damianmoore/audio-lighting-broadcast/kicad/transmitter/transmitter.kicad_pcb

## KiCad design kicad/transmitter/transmitter.kicad_pcb (2020-02-24)

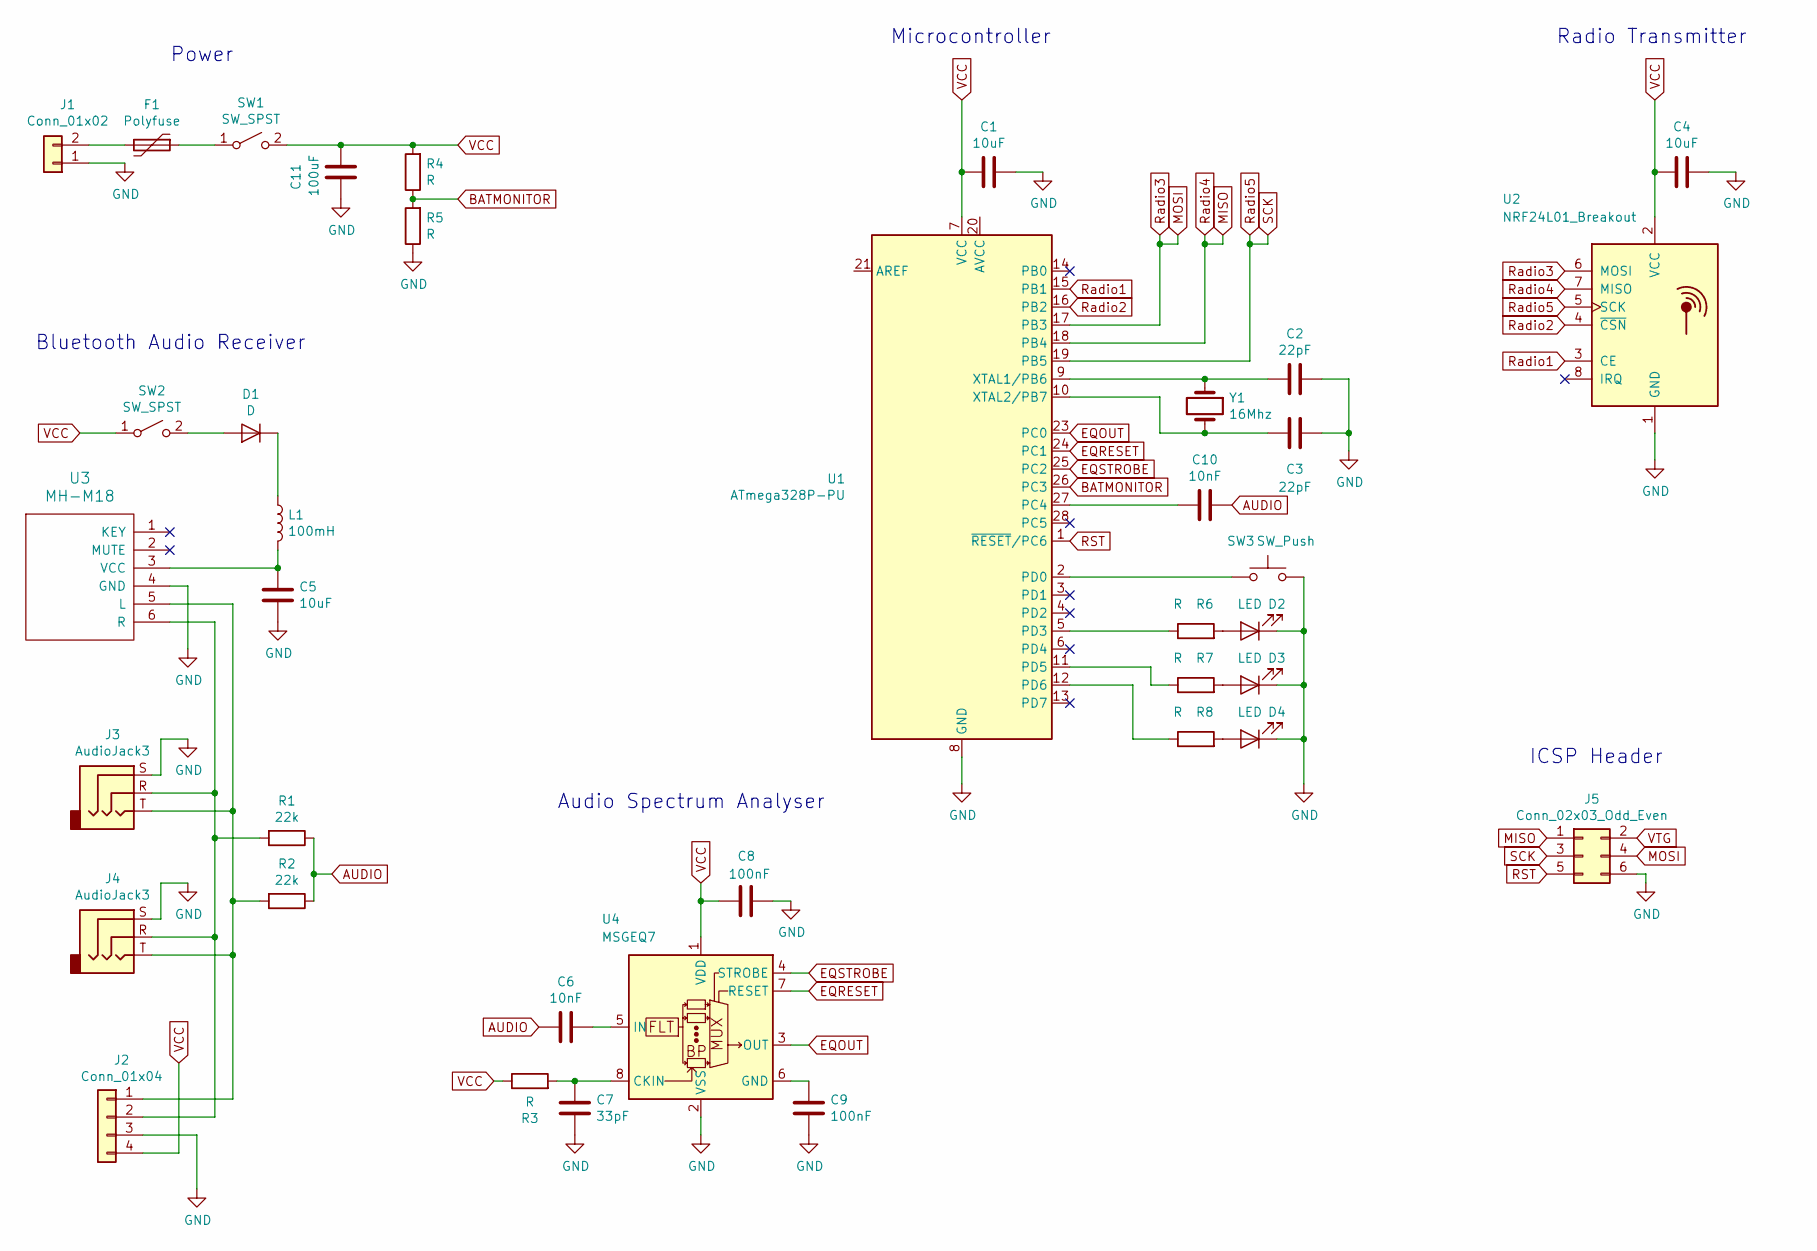
[picture p1: schematic transmitter.sch]

Parts:
C1, C4, C5: 10uF; C_0603_1608Metric_Pad1.05x0.95mm_HandSolder
C2, C3: 22pF; C_0603_1608Metric_Pad1.05x0.95mm_HandSolder
C6, C10: 10nF; C_0603_1608Metric_Pad1.05x0.95mm_HandSolder
C7: 33pF; C_0603_1608Metric_Pad1.05x0.95mm_HandSolder
C8, C9: 100nF; C_0603_1608Metric_Pad1.05x0.95mm_HandSolder
C11: 100uF; CP_Radial_D6.3mm_P2.50mm
D1: D; D_A-405_P7.62mm_Horizontal
D2, D3, D4: LED; LED_D3.0mm
F1: Polyfuse; Resonator-2Pin_W6.0mm_H3.0mm
J1: Conn_01x02; SolderWirePad_1x02_P3.81mm_Drill1mm
J2: Conn_01x04; PinHeader_1x04_P2.54mm_Vertical
J3, J4: AudioJack3; 3.5mm_Stereo_Jack
J5: Conn_02x03_Odd_Even; PinHeader_2x03_P2.54mm_Vertical
L1: 100mH; L_Toroid_Vertical_L16.0mm_W8.0mm_P7.62mm
R1, R2: 22k; R_0603_1608Metric_Pad1.05x0.95mm_HandSolder
R3, R4, R5, R6, R7, R8: R; R_0603_1608Metric_Pad1.05x0.95mm_HandSolder
SW1, SW2: SW_SPST; PinHeader_1x02_P2.54mm_Vertical
SW3: SW_Push; PinHeader_1x02_P2.54mm_Vertical
U1: ATmega328P-PU; DIP-28_W7.62mm
U2: NRF24L01_Breakout; nRF24L01_Breakout
U3: MH-M18; MH-M18_Bluetooth_Audio
U4: MSGEQ7; DIP-8_W10.16mm
Y1: 16Mhz; Crystal_HC18-U_Vertical

Connections:
AUDIO: C6.2, C10.1, R1.1, R2.1
BATMONITOR: R4.1, R5.2, U1.26 (PC3)
EQOUT: U1.23 (PC0), U4.3 (OUT)
EQRESET: U1.24 (PC1), U4.7 (RESET)
EQSTROBE: U1.25 (PC2), U4.4 (STROBE)
GND: C1.1, C2.1, C3.1, C4.1, C5.2, C7.1, C8.2, C9.1, C11.1, D2.1 (K), D3.1 (K), D4.1 (K), J1.1, J2.3, J3.S, J4.S, J5.6, R5.1, SW3.2, U1.8 (GND), U1.22 (GND), U2.1 (GND), U3.4 (GND), U4.2 (VSS)
MISO: J5.1, U1.18 (PB4), U2.7 (MISO)
MOSI: J5.4, U1.17 (PB3), U2.6 (MOSI)
unnamed: C2.2, U1.9 (XTAL1/PB6), Y1.1
unnamed: C3.2, U1.10 (XTAL2/PB7), Y1.2
unnamed: C5.1, L1.2, U3.3 (VCC)
unnamed: C6.1, U4.5 (IN)
unnamed: C7.2, R3.2, U4.8 (CKIN)
unnamed: C9.2, U4.6 (GND)
unnamed: C10.2, U1.27 (PC4)
unnamed: D1.1 (K), L1.1
unnamed: D1.2 (A), SW2.2 (B)
unnamed: D2.2 (A), R6.2
unnamed: D3.2 (A), R7.2
unnamed: D4.2 (A), R8.2
unnamed: F1.1, SW1.1 (A)
unnamed: F1.2, J1.2
unnamed: J2.1, J3.T, J4.T, R2.2, U3.5 (L)
unnamed: J2.2, J3.R, J4.R, R1.2, U3.6 (R)
unnamed: R6.1, U1.5 (PD3)
unnamed: R7.1, U1.11 (PD5)
unnamed: R8.1, U1.12 (PD6)
unnamed: SW3.1, U1.2 (PD0)
RST: J5.5, U1.1 (~RESET~/PC6)
Radio1: U1.15 (PB1), U2.3 (CE)
Radio2: U1.16 (PB2), U2.4 (~CSN)
Radio5: J5.3, U1.19 (PB5), U2.5 (SCK)
VCC: C1.2, C4.2, C8.1, C11.2, J2.4, R3.1, R4.2, SW1.2 (B), SW2.1 (A), U1.7 (VCC), U2.2 (VCC), U4.1 (VDD)
VTG: J5.2

Notes on the sheet:
Power
Bluetooth Audio Receiver
Audio Spectrum Analyser
Microcontroller
Radio Transmitter
ICSP Header

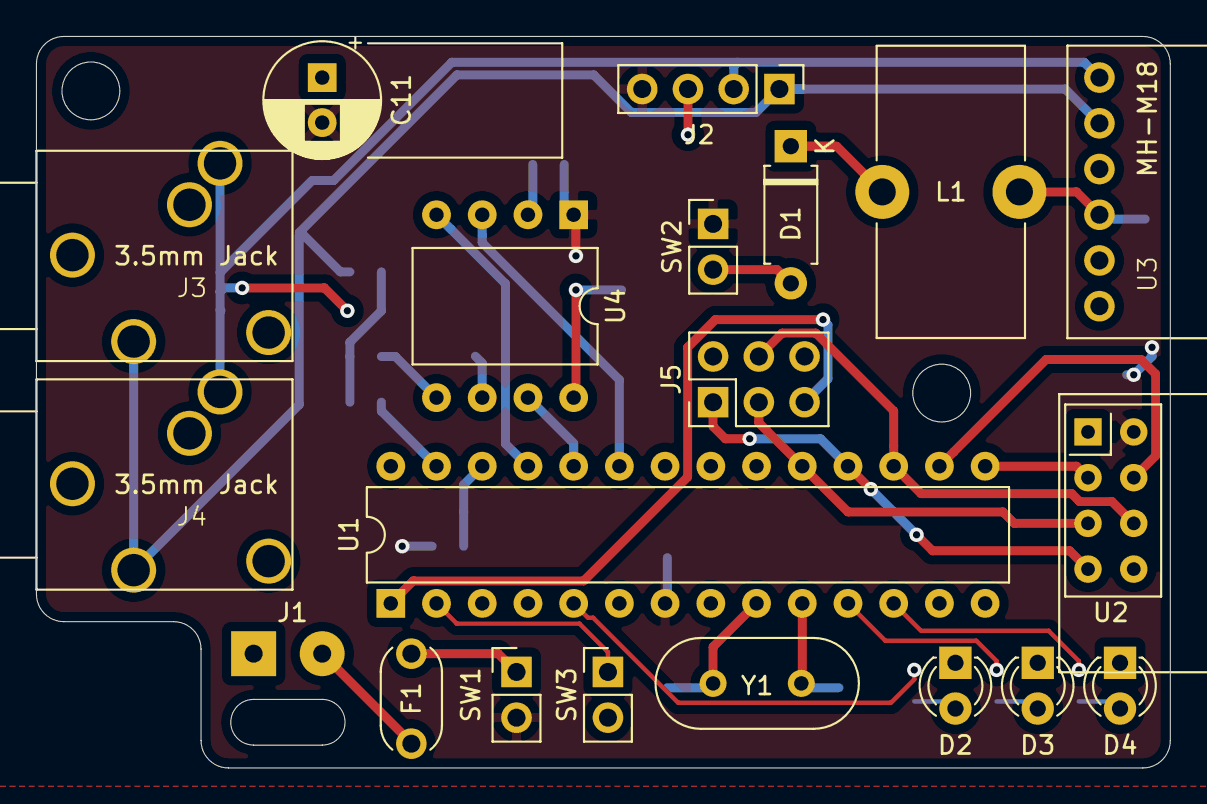
[picture p2: board transmitter.kicad_pcb from above]

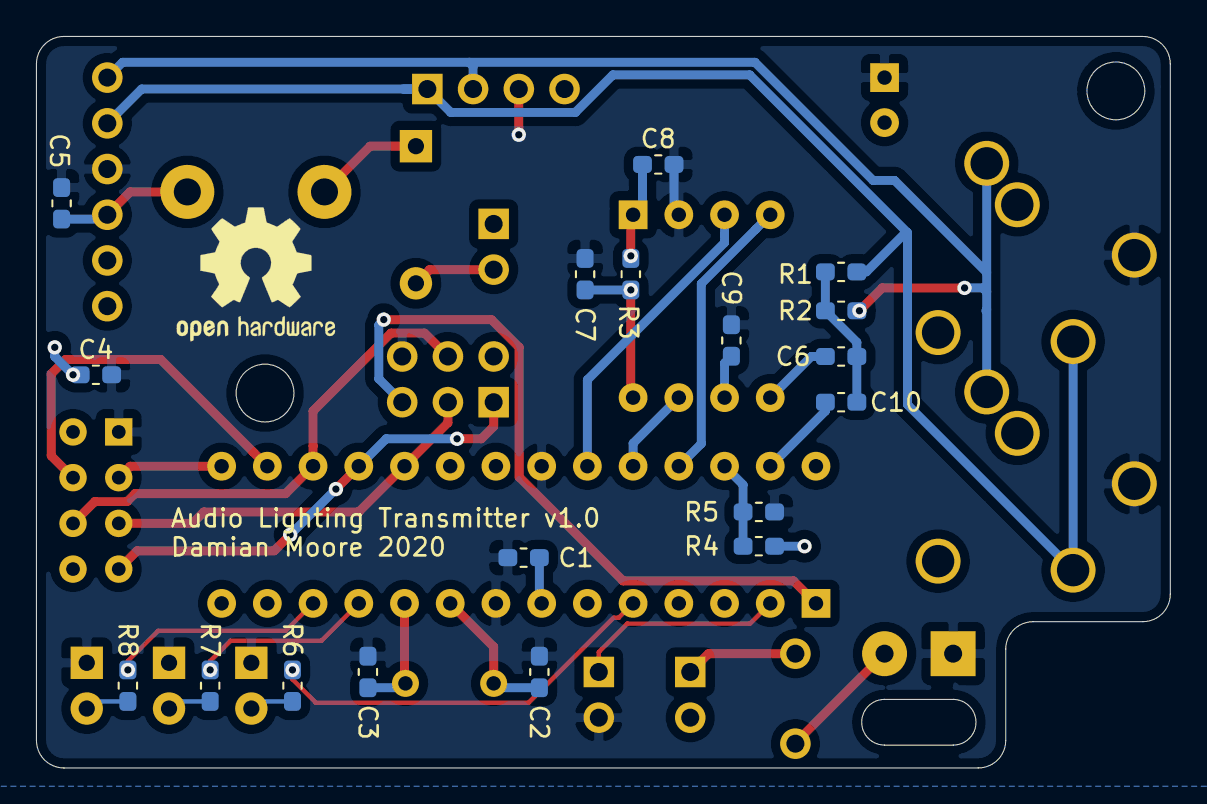
[picture p3: board transmitter.kicad_pcb from below]

Board: 2 copper layers, 63.0 x 40.6 mm, 38 parts (18 on the bottom side), 33 nets.
