damianmoore/audio-lighting-broadcast/kicad/leds/leds.kicad_pcb

## KiCad design kicad/leds/leds.kicad_pcb (2020-02-11)

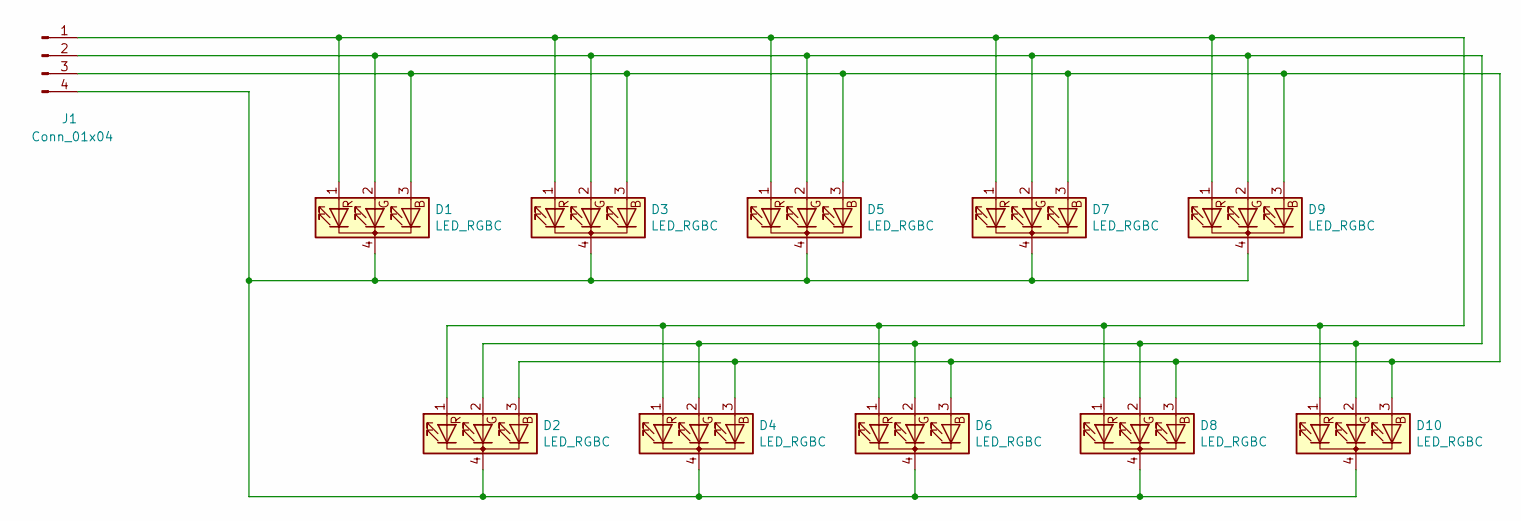
[picture p4: schematic leds.sch]

Parts:
D1, D2, D3, D4, D5, D6, D7, D8, D9, D10: LED_RGBC; LED_D5.0mm-4_RGB_swapped_pins
J1: Conn_01x04; Pin_Header_Straight_Simplified_1x04_Pitch2.54mm

Connections:
unnamed: D1.1 (RA), D2.1 (RA), D3.1 (RA), D4.1 (RA), D5.1 (RA), D6.1 (RA), D7.1 (RA), D8.1 (RA), D9.1 (RA), D10.1 (RA), J1.1
unnamed: D1.2 (GA), D2.2 (GA), D3.2 (GA), D4.2 (GA), D5.2 (GA), D6.2 (GA), D7.2 (GA), D8.2 (GA), D9.2 (GA), D10.2 (GA), J1.2
unnamed: D1.3 (BA), D2.3 (BA), D3.3 (BA), D4.3 (BA), D5.3 (BA), D6.3 (BA), D7.3 (BA), D8.3 (BA), D9.3 (BA), D10.3 (BA), J1.3
unnamed: D1.4 (K), D2.4 (K), D3.4 (K), D4.4 (K), D5.4 (K), D6.4 (K), D7.4 (K), D8.4 (K), D9.4 (K), D10.4 (K), J1.4

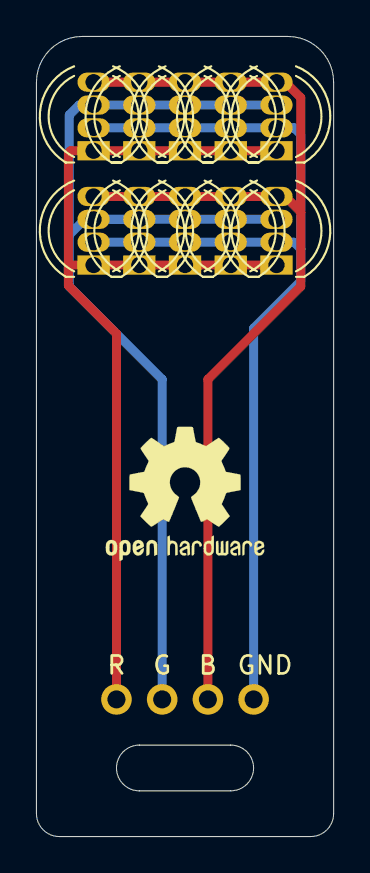
[picture p5: board leds.kicad_pcb from above]

Board: 2 copper layers, 16.5 x 44.5 mm, 11 parts (0 on the bottom side), 4 nets.
