damianmoore/audio-lighting-broadcast/kicad/receiver/receiver.kicad_pcb

## KiCad design kicad/receiver/receiver.kicad_pcb (2020-01-12)

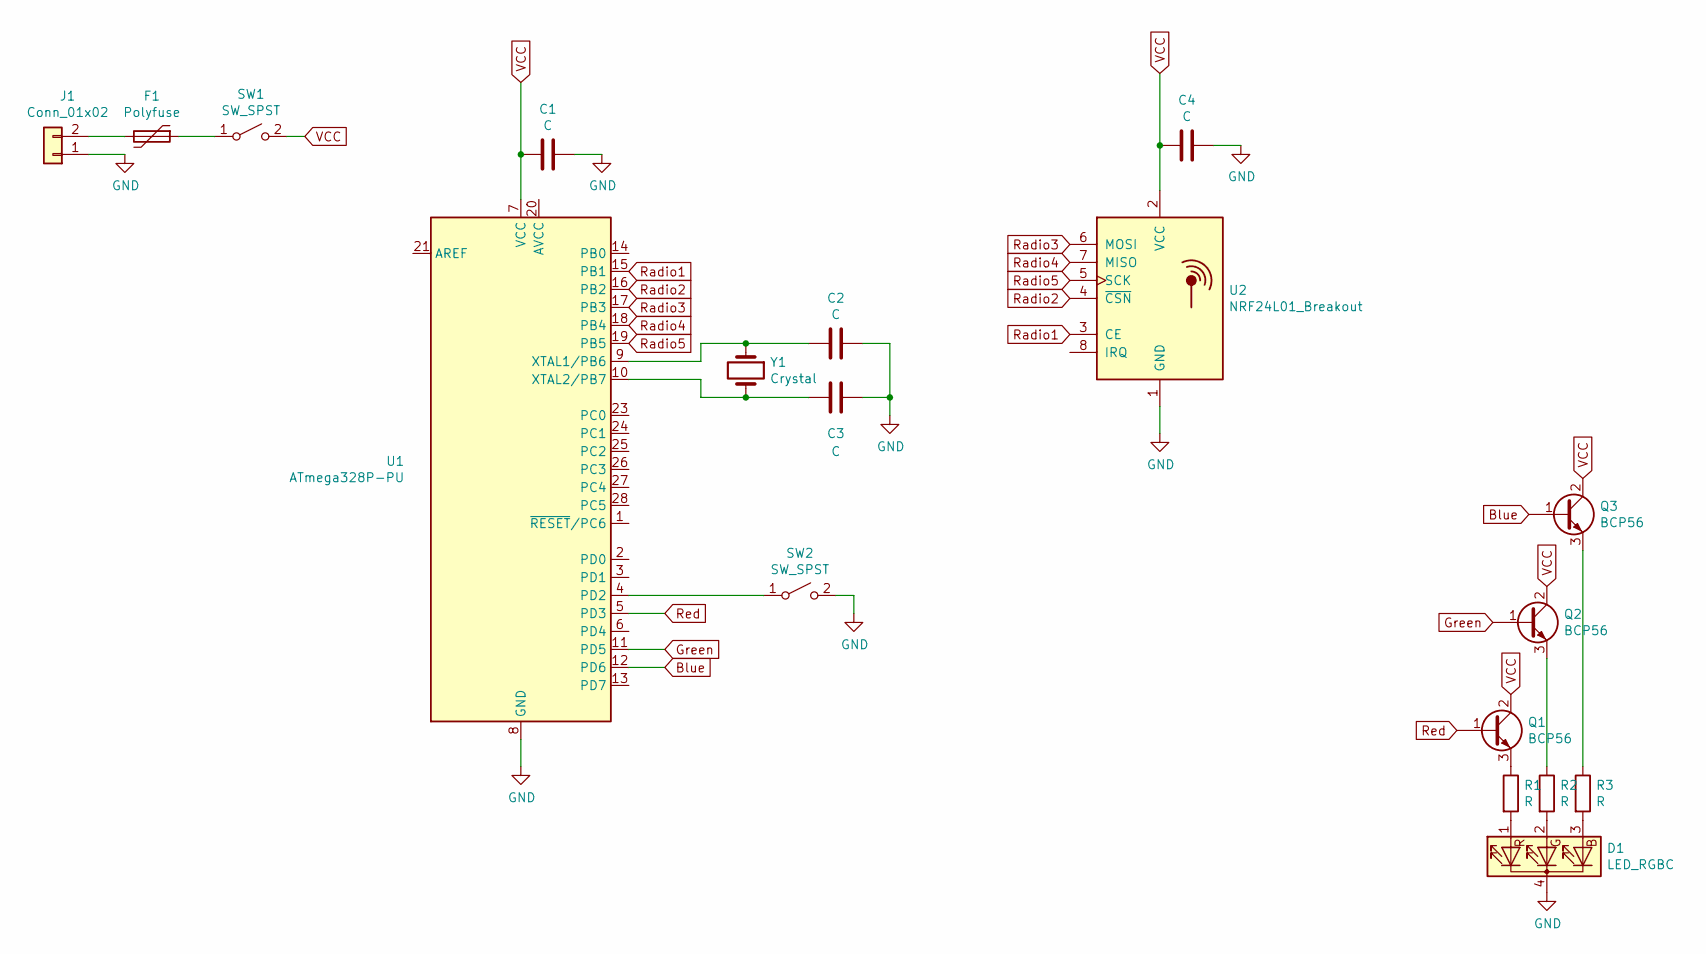
[picture p6: schematic receiver.sch]

Parts:
C1, C2, C3, C4: C; C_Disc_D3.0mm_W1.6mm_P2.50mm
D1: LED_RGBC; SolderWirePad_1x04_P3.175mm_Drill0.8mm
F1: Polyfuse; Crystal_HC18-U_Vertical
J1: Conn_01x02; SolderWirePad_1x02_P3.81mm_Drill1mm
Q1, Q2, Q3: BCP56; SOT-223-3_TabPin2
R1, R2, R3: R; R_Axial_DIN0207_L6.3mm_D2.5mm_P7.62mm_Horizontal
SW1, SW2: SW_SPST; SolderWirePad_1x02_P3.81mm_Drill1mm
U1: ATmega328P-PU; DIP-28_W7.62mm
U2: NRF24L01_Breakout; nRF24L01_Breakout
Y1: Crystal; Crystal_HC18-U_Vertical

Connections:
Blue: Q3.1 (B), U1.12 (PD6)
GND: C1.1, C2.1, C3.1, C4.1, D1.4 (K), J1.1, SW2.2 (B), U1.8 (GND), U1.22 (GND), U2.1 (GND)
Green: Q2.1 (B), U1.11 (PD5)
unnamed: C2.2, U1.9 (XTAL1/PB6), Y1.1
unnamed: C3.2, U1.10 (XTAL2/PB7), Y1.2
unnamed: D1.1 (RA), R1.2
unnamed: D1.2 (GA), R2.2
unnamed: D1.3 (BA), R3.2
unnamed: F1.1, SW1.1 (A)
unnamed: F1.2, J1.2
unnamed: Q1.3 (E), R1.1
unnamed: Q2.3 (E), R2.1
unnamed: Q3.3 (E), R3.1
unnamed: SW2.1 (A), U1.4 (PD2)
Radio1: U1.15 (PB1), U2.3 (CE)
Radio2: U1.16 (PB2), U2.4 (~CSN)
Radio3: U1.17 (PB3), U2.6 (MOSI)
Radio4: U1.18 (PB4), U2.7 (MISO)
Radio5: U1.19 (PB5), U2.5 (SCK)
Red: Q1.1 (B), U1.5 (PD3)
VCC: C1.2, C4.2, Q1.2 (C), Q1.4 (C), Q2.2 (C), Q2.4 (C), Q3.2 (C), Q3.4 (C), SW1.2 (B), U1.7 (VCC), U2.2 (VCC)

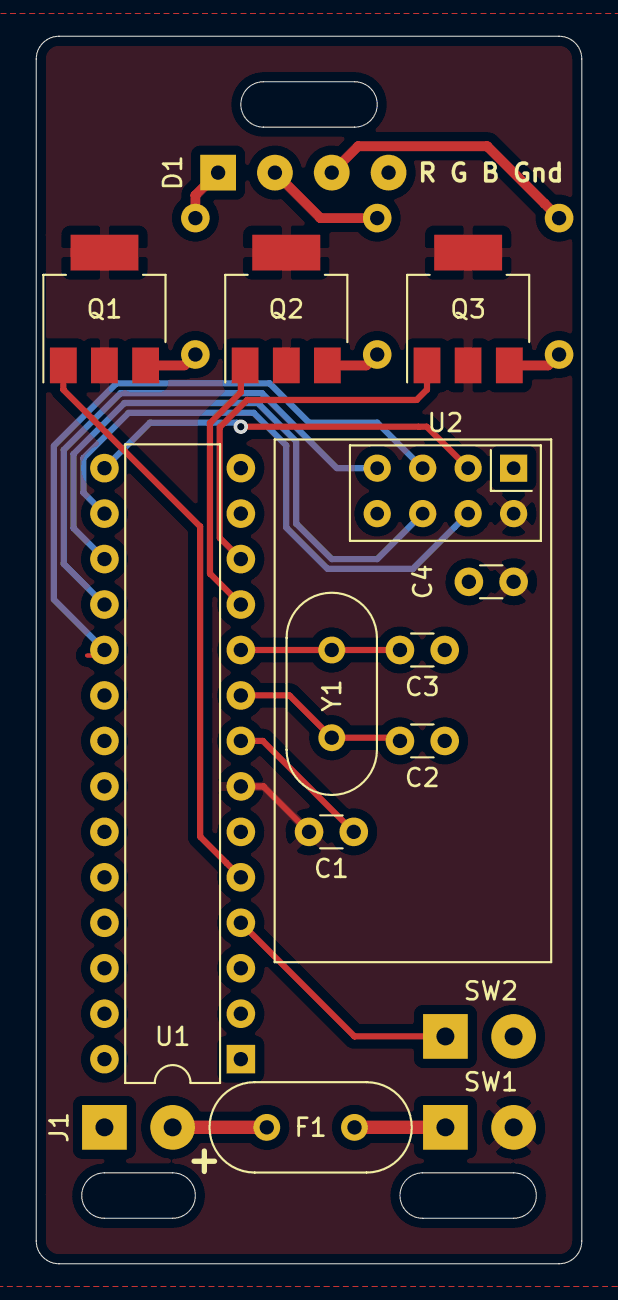
[picture p7: board receiver.kicad_pcb from above]

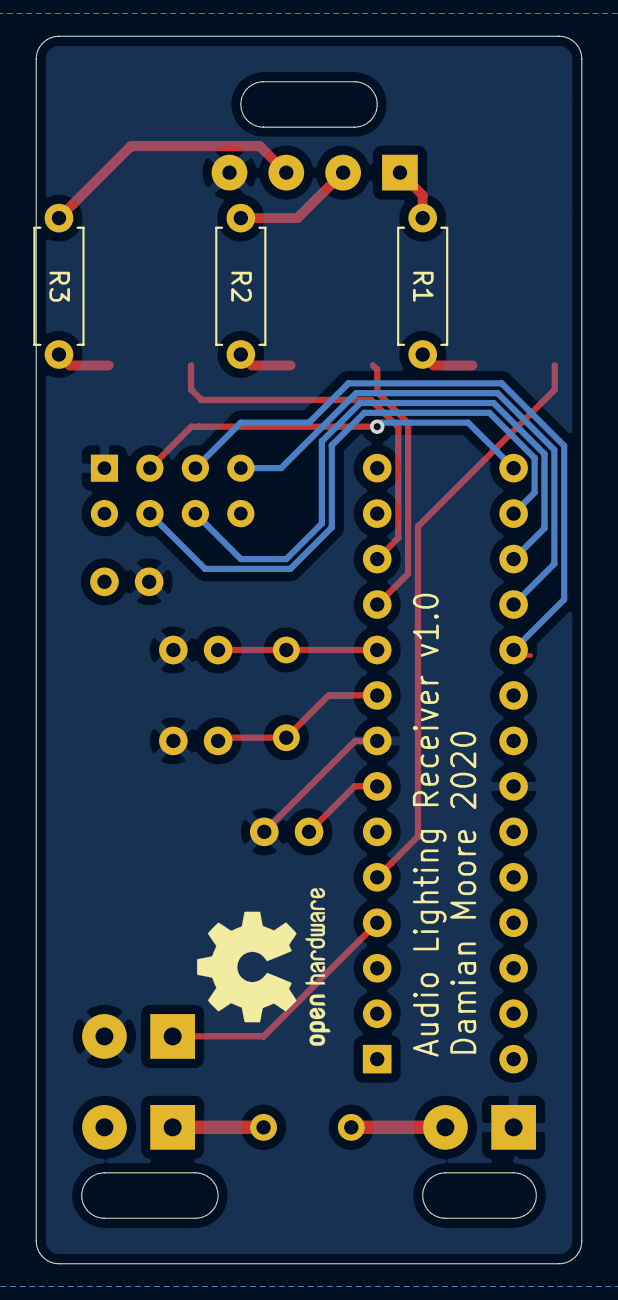
[picture p8: board receiver.kicad_pcb from below]

Board: 2 copper layers, 30.5 x 68.6 mm, 18 parts (3 on the bottom side), 21 nets.
