damianmoore/audio-lighting-broadcast/(commit log)

2020-01-12 KiCad files for receiver
    [receiver-B_Cu.gbr, receiver-B_Mask.gbr, receiver-B_Paste.gbr, receiver-B_SilkS.gbr, receiver-Edge_Cuts.gbr, receiver-F_Cu.gbr, receiver-F_Mask.gbr, receiver-F_Paste.gbr]
2020-01-12 Transmitter and receiver Arduino source files
2020-01-13 Receiver remembers which mode (bass/mid/treb) it was listening to across power-downs. Resets radio if a crash occurs.
    [receiver.ino]
2020-01-17 CNC Gcode files for case end caps
2020-02-06 Schematic and PCB for LEDs
    [leds-B_Cu.gbr, leds-B_Mask.gbr, leds-B_Paste.gbr, leds-B_SilkS.gbr, leds-Edge_Cuts.gbr, leds-F_Cu.gbr, leds-F_Mask.gbr, leds-F_Paste.gbr]
2020-02-11 First pass at transmitter schematic and PCB
    [transmitter.kicad_pcb, transmitter.sch]
2020-02-11 Button, LEDs, ICSP header
    [transmitter-B_Cu.gbr, transmitter-B_Mask.gbr, transmitter-B_Paste.gbr, transmitter-B_SilkS.gbr, transmitter-Edge_Cuts.gbr, transmitter-F_Cu.gbr, transmitter-F_Mask.gbr, transmitter-F_Paste.gbr]
2020-02-11 Tidy-ups pre-order
    [leds-B_Cu.gbr, leds-B_Mask.gbr, leds-B_Paste.gbr, leds-B_SilkS.gbr, leds-Edge_Cuts.gbr, leds-F_Cu.gbr, leds-F_Mask.gbr, leds-F_Paste.gbr]
2020-02-24 Removes unused silkscreen symbol from PCB
    [transmitter-B_Cu.gbr, transmitter-B_Mask.gbr, transmitter-B_Paste.gbr, transmitter-B_SilkS.gbr, transmitter-Edge_Cuts.gbr, transmitter-F_Cu.gbr, transmitter-F_Mask.gbr, transmitter-F_Paste.gbr]
2020-03-12 Resistor and capacitor values
    [transmitter.sch]
